motorcountry/plot/3d打印件/7.ca ban lian jie gan (parallel).stl

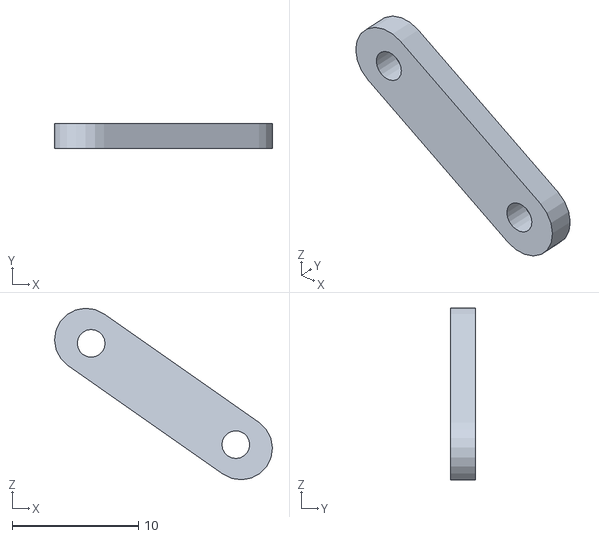
[picture p4: CAD file, 2022-11-07]
3d打印件/7.ca ban lian jie gan (parallel).stl
17.3 x 2.00 x 13.6
