motorcountry/plot/3d打印件/4.1 ji xie bi da (arm big) .stl

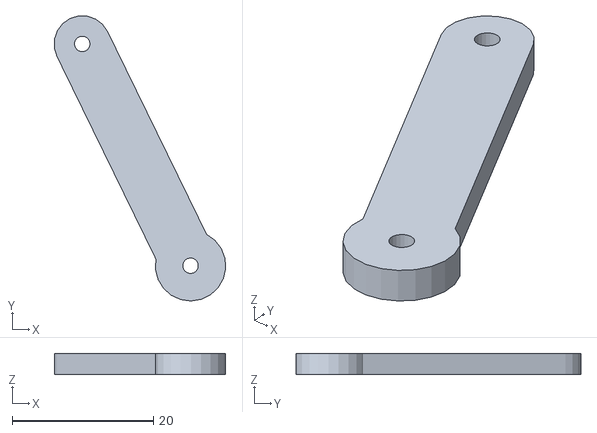
[picture p5: CAD file, 2022-11-07]
3d打印件/4.1 ji xie bi da (arm big) .stl
24.3 x 40.4 x 3.00
