motorcountry/plot/3d打印件/6.lian jie gan (shank).stl

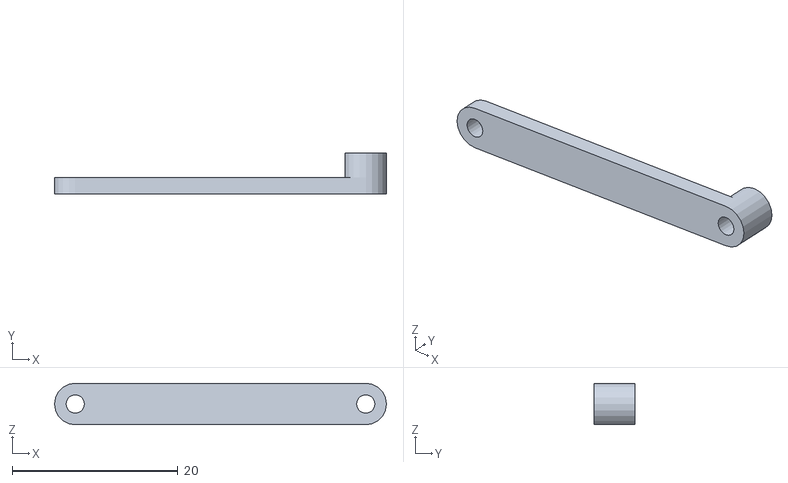
[picture p6: CAD file, 2022-11-07]
3d打印件/6.lian jie gan (shank).stl
40.0 x 5.00 x 5.00
