motorcountry/plot/3d打印件/2.shou bi ji jia (arm bracket).stl

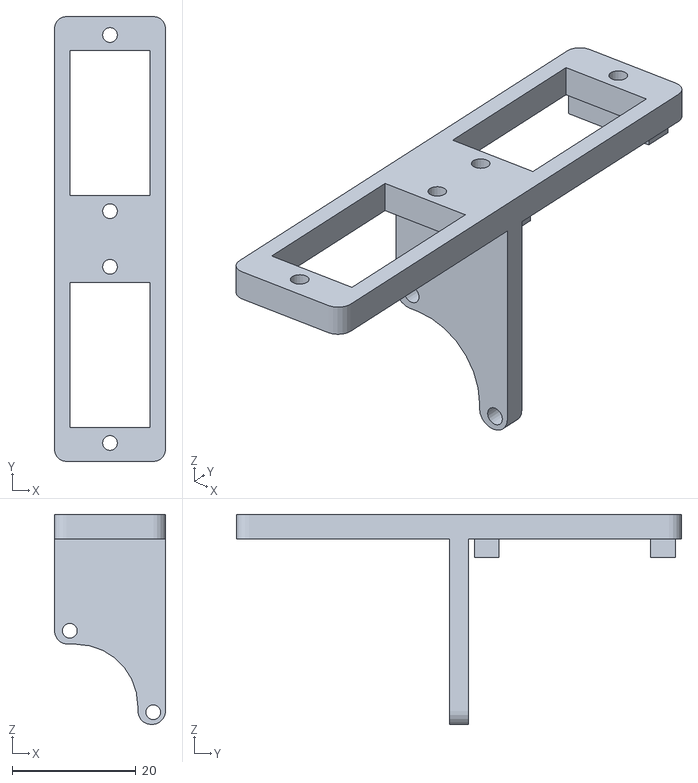
[picture p7: CAD file, 2022-11-07]
3d打印件/2.shou bi ji jia (arm bracket).stl
18.0 x 72.0 x 34.0
