motorcountry/plot/3d打印件/1.di jia (chassis).stl

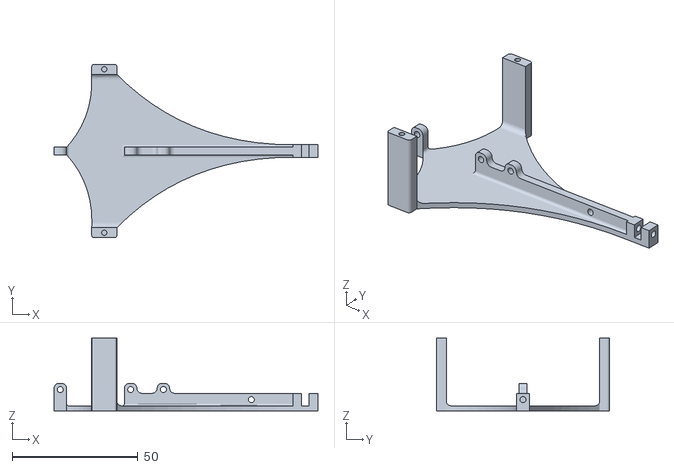
[picture p8: CAD file, 2022-11-07]
3d打印件/1.di jia (chassis).stl
105.0 x 69.0 x 29.0
