motorcountry/plot/3d打印件/9.ca ban (magnet).stl

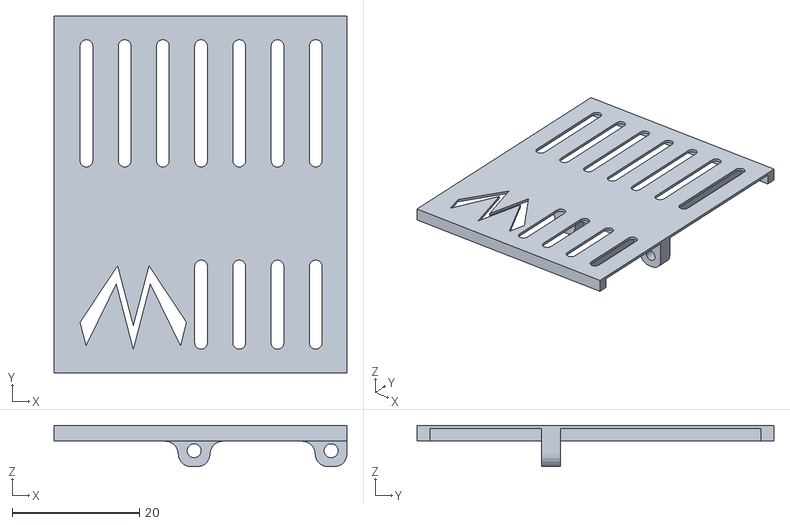
[picture p9: CAD file, 2022-11-07]
3d打印件/9.ca ban (magnet).stl
46.0 x 56.0 x 6.50
