motorcountry/plot/3d打印件/3.wo bi (pen arm).stl

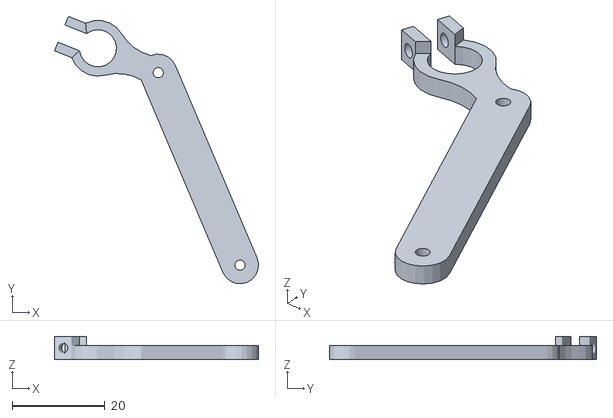
[picture p10: CAD file, 2022-11-07]
3d打印件/3.wo bi (pen arm).stl
43.9 x 57.5 x 5.00
