motorcountry/plot/3d打印件/8.ca ban lian jie gan (servo parallel).stl

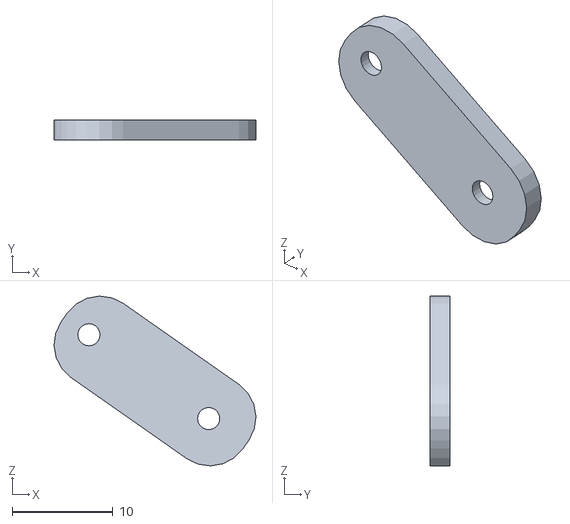
[picture p11: CAD file, 2022-11-07]
3d打印件/8.ca ban lian jie gan (servo parallel).stl
20.0 x 2.00 x 16.8
