motorcountry/plot/3d打印件/5.ji xie bi (arm small).stl

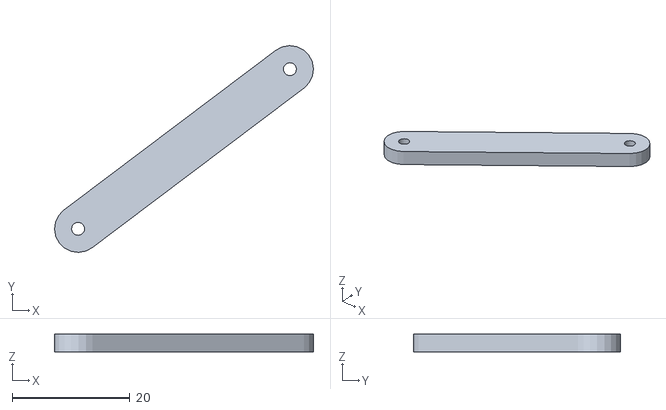
[picture p12: CAD file, 2022-11-07]
3d打印件/5.ji xie bi (arm small).stl
43.9 x 35.1 x 3.00
